HelaFaye/SlimeVR-Tracker-ESP-Hardware/out/hub/slimevr-i2spi-hub.kicad_sch

## KiCad design out/hub/slimevr-i2spi-hub.kicad_sch (2026-10-13)

Schematic: slimevr-i2spi-hub.kicad_sch

Parts:
C1, C2, C5: 100n; C_0402_1005Metric
C3: 10u; C_0402_1005Metric
C4: 22u; C_0402_1005Metric
D1: LED; LED_0603_1608Metric
D2: CHG; LED_0603_1608Metric
J1: RJ45-CHAIN; RJ45_Amphenol_54602-x08_Horizontal
J2: LiPo; JST_PH_S2B-PH-SM4-TB_1x02-1MP_P2.00mm_Horizontal
J3: USB-C; USB_C_Receptacle_HRO_TYPE-C-31-M-12
J4: UART; JST_PH_S2B-PH-SM4-TB_1x02-1MP_P2.00mm_Horizontal
R1, R2, R3: 33; R_0402_1005Metric
R4, R5: 2k2; R_0402_1005Metric
R6, R7: 4k7; R_0402_1005Metric
R8: 2k; R_0402_1005Metric
R9, R12: 100k; R_0402_1005Metric
R10: 220k; R_0402_1005Metric
R11, R15: 1k; R_0402_1005Metric
R13, R14: 5k1; R_0402_1005Metric
R16, R17, R18: 10k; R_0402_1005Metric
SW1: BOOT; JST_PH_S2B-PH-SM4-TB_1x02-1MP_P2.00mm_Horizontal
U1: ESP32-C5-WROOM-1
U2: ICM-45686; LGA-14_2.5x3mm_P0.5mm
U3: QMC6309
U4: AP2112K-3.3; SOT-23-5
U5: MCP73831; SOT-23-5
