HelaFaye/SlimeVR-Tracker-ESP-Hardware/out/node/slimevr-i2spi-node.kicad_sch

## KiCad design out/node/slimevr-i2spi-node.kicad_sch (2026-10-13)

Schematic: slimevr-i2spi-node.kicad_sch

Parts:
C1, C2, C3: 100n; C_0402_1005Metric
C4: 10u; C_0402_1005Metric
C5: 1u; C_0402_1005Metric
J1: RJ45-IN; RJ45_Amphenol_54602-x08_Horizontal
J2: RJ45-OUT; RJ45_Amphenol_54602-x08_Horizontal
Q1: DMG2305UX; SOT-23
R1: 100k; R_0402_1005Metric
R2, R3, R4: 4k7; R_0402_1005Metric
TP1: UPDI; TestPoint_Pad_D1.0mm
U1: ATtiny412; SOIC-8_3.9x4.9mm_P1.27mm
U2: ICM-45686; LGA-14_2.5x3mm_P0.5mm
U3: QMC6309
