HelaFaye/SlimeVR-Tracker-ESP-Hardware/(commit log)

2026-09-07 Add ESP32-C5 support and I2SPI remote chip select over RJ45
    Three related pieces of work. Design rationale and the reasoning behind each
    major choice are in docs/dev/DECISIONS.md (DEC-001 through DEC-013); the running
    log is docs/dev/PROGRESS.md.
    ESP32-C5 board support
    - Board ids BOARD_ESP32C5_DEVKITC1, BOARD_ESP32C5_RJ45_HUB and
    BOARD_SLIMEVR_C5_CHAIN_HUB, with PlatformIO envs on the pioarduino platform.
    Official espressif32 has no C5 target (DEC-001).
    - i2cscan pin tables for the C5, excluding flash/PSRAM, USB-JTAG, strapping and
    boot-mode pins.
    - WiFiNetwork::setUp() selects a Wi-Fi band explicitly between WiFi.mode() and
    the first WiFi.begin(). Arduino-ESP32 defaults dual-band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
2026-09-07 Add gated sensor power and a KiCad hardware generator
    Firmware: each node switches its sensor's 3V3 through a P-channel pass MOSFET.
    Sensors boot off and ATTinyCSBus::init() stages them online one at a time, so a
    faulty sensor is attributable to a node and inrush is spread rather than summed.
    Gate polarity fails de-energised: a pull-up holds the FET off whenever the ATtiny
    is not driving it. Ten new simulation checks, 39 total.
    hardware/gen: parts library with verified symbols and footprints, a generated
    project library for the ESP32-C5, ICM-45686 and QMC6309 which KiCad 7 does not
    ship, schematic emission, a JLCPCB BOM and a KiKit V-score panel config. Layout
    is deliberately not generated;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
    [bom-jlcpcb.csv, slimevr-i2spi-hub.kicad_sch, slimevr-i2spi-node.kicad_sch]
2026-09-07 Vendor Espressif and Mumo KiCad libraries; document I2SPI
    docs/I2SPI.md consolidates the RJ45 pinout and the v2 wire protocol.
    Espressif's own C5 symbol corrected a live bug: BOARD_SLIMEVR_C5_CHAIN_HUB had SPI
    MISO/MOSI on GPIO11/GPIO12, which are U0TXD/U0RXD on the module. Moved to GPIO9/8,
    INT to 15, LED to 23.
    QMC6309 is a 4-pad WLCSP, not the DFN-6 the placeholder assumed. Both parts now
    sourced from vendored libraries. ICM-45686 remains the only unverified pinout.
    [bom-jlcpcb.csv, slimevr-i2spi-hub.kicad_sch, slimevr-i2spi-node.kicad_sch]
2026-09-07 Verification audit: fix CCL LUT number, strip fabricated part numbers
    Checked ~30 load-bearing claims against primary sources. Four were wrong, two
    were live:
    - PA7 on an 8-pin tinyAVR is LUT1-OUT, not LUT0's alternate (LUT0-OUT is PA4,
    absent from the package). The node firmware configured Logic0, whose output
    cannot reach a pin, so the strobe pass-through would not have worked.
    - Every LCSC part number was fabricated. The one checkable is wrong. Stripped to
    None so the BOM fails at upload rather than at assembly.
    - ICM-45686 draws 0.42 mA in 6-axis low-noise mode, not the 2.5 mA estimated.
    Verified correct: all ESP32-C5 GPIO restrictions, boot-mode pins, ADC placement,
    the IMU pack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
    [bom-jlcpcb.csv, slimevr-i2spi-hub.kicad_sch, slimevr-i2spi-node.kicad_sch]
2026-09-07 Make the verification suite distribution-independent
    KiCad library search now covers Arch, Debian and macOS layouts with
    KICAD_SYMBOL_DIR/KICAD_FOOTPRINT_DIR overrides. VERIFY.sh skips suites whose
    tools are absent instead of failing, honours CXX/AVR_GCC/CLANG_FORMAT, and warns
    when clang-format is not the version CI pins. docs/dev/SETUP.md covers Arch and
    Debian, including the externally-managed-Python and KiCad 10 gotchas.
    [verify.py]
2026-09-07 Resolve KiCad symbol names across versions instead of pinning one
    Device:Q_PMOS_GSD exists in KiCad 7 and not in 10, which failed verification on
    Arch. Parts may now list alternatives separated by '|'; verify.py resolves the
    first that exists and, when none do, greps the installed libraries and prints the
    near-misses. Also fixes a missing 're' import that made the suggestion path raise
    NameError on every call - unnoticed because the test captured only stdout.
    [parts.py, verify.py]
2026-09-07 Resolve symbols on pin function, not just existence
    Parts may declare pin_functions; verify.py reads the actual pin names from each
    candidate symbol and accepts one only if it matches. KiCad ships all four PMOS
    pin orderings, so resolving on existence alone can silently pick a symbol that
    drives the wrong pad - which was the manual caveat this replaces.
    test_pin_order.py breaks the config four ways and asserts each is caught, and is
    wired into VERIFY.sh. Also fixes a status line that printed [ok] above a
    pin-order failure, and __pycache__ staleness that made the test report false
    passes (mutations share size and mtime-second, and CPython keys bytecode on
    both).
    [parts.py, test_pin_order.py, verify.py]
2026-09-07 Apply the datasheets: ICM-45686 pinout was wrong on 10 of 14 pins
    - ICM-45686 pin table read from TDK DS-000577 Rev 1.0. The guess had AP_SDO,
    AP_CS, AP_SCLK and AP_SDI all on wrong pads; only the power pins were right.
    No unverified pinouts remain.
    - SensorPowerOnSettleMillis 10 -> 15 ms: the QMC6309 needs PSUP (<10 ms) plus
    PORT (<3 ms) before it accepts I2C.
    - QMC6309 draws 2000 uA at the ODR and oversampling the firmware selects, not
    the 0.5 mA estimated. Per-node current 4 -> 5.4 mA.
    - GPIO3 is MTDI, a strapping pin; hub CS moved to GPIO0. GPIO15 is SPICS1 on
    PSRAM modules; IMU interrupt moved to GPIO24. GPIO11/12 are the console UART.
    The C5 scan table drops from 14 pins to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
    [boards.py, mklib.py, parts.py, pinouts.py, test_pin_order.py, verify.py]
2026-10-07 Skip the KiCad suites when no symbol library is installed
    VERIFY.sh promises that suites whose tools are missing are skipped with a
    note rather than failed, but it only kept that promise for avr-gcc. On a
    machine without KiCad the two stock-symbol suites reported 24 "problems"
    and 3 failed guard cases, then printed FAILURES ABOVE and exited 1 -- all
    environment, no defect. A verification script that cries wolf on a clean
    tree is worse than no script, because the next real failure reads as more
    of the same noise.
    verify.py gains --have-libs, which answers the one question VERIFY.sh needs
    (is a symbol library reachable beyond this project's own two?) using the
    same search path the checks them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
    [verify.py]
2026-10-07 Stand up as its own repo, split from SlimeVR-Tracker-ESP
    History is the hardware/ subtree of the firmware fork, extracted with git filter-repo,
    so every file keeps its commits. Paths that said hardware/... now say ./... .
    New here:
    - verify.sh: the hardware checks that used to run from the firmware's VERIFY.sh.
    - gen/check_build_totals.py: the BOM and panel checks, moved out of the firmware's
    sim/check_numbers.py because they only read gen/boards.py and gen/panel.py.
    - README header saying which repo owns what. The wire protocol and cable pinout stay
    in the firmware repo.
    - MIT / Apache-2.0 licence files, matching the firmware this was split from.
    i2c_address_map.py stayed in the firmw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
2026-10-12 Fix the node ATtiny412 pinout; regenerate stale outputs
    gen/boards.py wired the node's ATtiny412 as if pin 2 were UPDI and pin 6 the strobe. The
    SOIC-8 part is 1 VCC, 2 PA6, 3 PA7, 4 PA1, 5 PA2, 6 PA0/UPDI, 7 PA3, 8 GND (KiCad's
    ATtiny202-SS symbol, which ATtiny412-SS extends), so six of eight pins were on the wrong
    pads: strobe, chip select, both chain I2C lines, UPDI and the sensor power gate.
    - ATTINY412 now declares pin_functions, and gen/check_node_pins.py checks the board's
    nets against both that map and the ports the node firmware drives. It runs in
    verify.sh, needs no KiCad, and reports 6 wrong on the old mapping.
    - verify.py follows (extends ...) in KiCad symbols; ATtiny412-SS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
    [bom-jlcpcb.csv, slimevr-i2spi-hub.kicad_sch, slimevr-i2spi-node.kicad_sch]
2026-10-12 Check pins against pads, fix the USB-C symbol, add CI, record licences
    verify.py:
    - Every symbol pin must have a pad on the part's footprint, and every pin a board wires
    must exist on its symbol. This caught the USB-C part: the full USB_C_Receptacle symbol
    has SuperSpeed pins the 16-pad HRO TYPE-C-31-M-12 has no pads for. It now uses
    USB_C_Receptacle_USB2.0_16P (USB_C_Receptacle_USB2.0 in KiCad 7), which matches pad
    for pad.
    - Unit sub-symbols are matched exactly: looking up Device:R also collected
    R_Network08's pins, which could pass or fail a pin map on another part's pins.
    - Hidden pins (bare `hide` before or after the length, or KiCad 9's (hide yes)) are
    read. Stacked power p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
    [slimevr-i2spi-hub.kicad_sch, slimevr-i2spi-node.kicad_sch]
2026-10-12 Point to the I2SPI specification as the standard for chain hardware
    Claude-Session: https://claude.ai/code/session_01Sb26stwPJiCMHhrBWZ2D9q
